atricat/wh51-emulation-sx1276/README.md

# wh51-emulation-sx1276

**Monitor your letterbox (or other device away from the house) with Home Assistant.**

This is code to emulate a WH51 soil moisture sensor with an ATtiny1614 MCU and a SX1276 (RFM95W) module. It transmits data that "fakes" the signals coming from an Ecowitt (Fine Offset) moisture sensor.

**Why would you need this?**

I needed a **long-range**, low-power (i.e. non 2.4GHz Wifi/Zigbee) **battery-powered** way to transmit sensor data to Home Assistant.
And I happened to already have WH51 moisture sensors and a gateway set up. These sensors use FSK modulation, and the SX1276 in the gateway can only listen either in FSK mode _or_ simple OOK/ASK mode. So it seemed easier to just "quickly" set something up to transmit using FSK. How naive... but I eventually got it to work.

**Alternative: ESPHome**: The [ESPHome SX127x component](https://esphome.io/components/sx127x/) potentially allows a similar setup: In a setup with multiple such SX127x ESPHome nodes, one of them acts as a gateway to Wi-Fi for Home Assistant, forwarding sensor data from the othres. Less coding, longer range if using LoRa, _but_ worse battery performance due to the use of ESP32, and you need another dedicated gateway running, instead of the one for the moisture sensors. Only little documentation exists, e.g. see [ESP32 LoRa Remote Sensor Node](https://esp32.co.uk/esp32-lora-remote-sensor-node-for-home-assistant-sx1276/).

**What works**

- Transmission at 868.35 MHz. The deviation of 35 kHz was measured with an SDR. Re-transmits after 5/10/60/300 seconds before going silent again, to ensure a new state goes through in case of e.g. radio interference.
- This shows up on my [LilyGo Lora32](https://lilygo.cc/products/lora3) (essentially an ESP32 and SX1276) running [OpenMQTTGateway](https://docs.openmqttgateway.com/), and thus also on Home Assistant.
- Logging to the same serial port that was used for programming the ATtiny. To enable logging, you need to press a key (e.g. Enter) during the first 3 seconds of startup, while the LED is still on.
- Reception of actual (genuine Ecowitt) WH51 transmissions, including AFC to figure out the exact frequency. (Needs a tiny bit of code hacking: Call the alternative `LoopRx()` from the start of `loop()`.)
- Home Assistant integration (see further below): If the mailbox flap/door is opened, send a notification to my phone. However, only do this if it is not me checking the mailbox - detect this by waiting for 5 minutes before the notification, and suppress it if the front door opens during that time.

**Caveats**

- For battery operation, note that the ATtiny will work from 1.8V at 5 MHz clock speed, from 2.7V at 10 MHz. So for best battery life, choose 5 MHz when compiling!
- 433 MHz and 915 MHz (SX1278 board) should work, but not tested.
- Unknown whether reception via the official Ecowitt gateway works, I do not own it.
- A [bug](https://github.com/1technophile/OpenMQTTGateway/issues/2356) in OpenMQTTGateway v1.8.1 prevented sending frequent updates, everything coming in from **any** device within 3 sec after an initial update was swallowed, even if the payload differed. It is **strongly recommended** to get a more recent version of OMG to avoid this problem. In the code, `MIN_UPDATE_DELAY_MS` (set to 3500 ms) provides a workaround, it causes updates of our device to get delayed until they will no longer be ignored. However, collisions with other devices within the 3 seconds cannot be avoided.

---

## Hardware notes

- MCU: ATtiny1614 (megaTinyCore / Arduino framework)
- Radio: SX1276, SPI, 32.000 MHz crystal (confirm yours matches - the frequency math in the code assumes exactly 32 MHz).
- PA output: configured for **PA_BOOST** (not RFO) - see "SX1276 TX register configuration" below. Most cheap SX1276 breakout boards (RFM95-style especially) only wire the antenna to PA_BOOST; RFO is often not connected at all on the PCB. If you are unsure about your board, first try reception only.
- **Never transmit without an antenna (or dummy load) connected.** An open-circuit PA output
  can degrade or damage the chip over repeated/high-power transmissions.

### Pin numbering

This is specific to the ATtiny1614 - take care to adapt as necessary for other MCUs.
[ATtiny1614/1616/1617 data sheet](https://ww1.microchip.com/downloads/aemDocuments/documents/MCU08/ProductDocuments/DataSheets/ATtiny1614-16-17-DataSheet-DS40002204A.pdf),
[SX1276 data sheet](https://www.semtech.com/products/wireless-rf/lora-connect/sx1276).

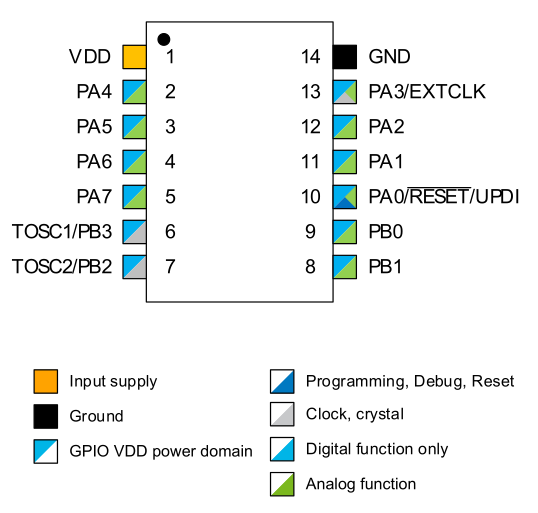
[picture p1: attiny1614-pinout.png]
pinout


| Physical pin | Name | Purpose |
|---|---|---|
| 1 | VDD  | 1.8V (at 5 MHz) to 3.3V - not 5V, the SX1276 does not like that |
| 2 | PA4  | SX1276 NSS/CS |
| 3 | PA5  | Reed 1 connected to GND |
| 4 | PA6  | Reed 2 connected to GND |
| 5 | PA7  | unused |
| 6 | PB3  | unused |
| 7 | PB2  | Serial output for log messages, see below |
| 8 | PB1  | Status LED connected to GND via ~330 Ohm (assuming a red LED) |
| 9 | PB0  | unused |
| 10 | PA0  | UPDI flashing |
| 11 | PA1  | SX1276 MOSI |
| 12 | PA2  | SX1276 MISO |
| 13 | PA3  | SX1276 SCK |
| 14 | GND  | Heh somehow it's needed |

The unused pins could of course be used for more analog or digital inputs.

_Implementation notes:_
I always use the named constants (`PIN_PA1`, `PIN_PB2`, etc.) rather than bare numbers to avoid confusion. This project got bitten by this repeatedly before switching to named constants everywhere.

Related, more general issue that applies beyond just this MCU: Raw AVR/megaAVR-0 registers expect different *kinds* of values depending on which register you're touching, and mixing
them up compiles fine but silently does the wrong thing:
- `DIRSET`/`DIRCLR`/`OUT.../IN`/`INTFLAGS` want a **bitmask** (`PIN1_bm`, or `digitalPinToBitMask(pin)`)
- `PORTx.PINnCTRL` access wants a **bit position** (`digitalPinToBitPosition(pin)`)
- Arduino API calls (`pinMode`, `digitalRead`, `digitalWrite`) want the **Arduino pin number**

### Serial/UPDI setup

**Raspberry Pico**

I used a Raspberry Pico with the [Noltari pico-uart-bridge](https://github.com/Noltari/pico-uart-bridge). With a simple setup with two resistors (however took a while to figure out the correct values), one can use the same cable to first program the ATtiny at 230400 baud, then read the output coming back at 9600 baud, e.g. using `minicom -D /dev/ttyACM0 -b 9600` (software/hardware flow control off!).

- Raspi Pico's GPIO16 (pin 21), UART0 TX is connected to a 1 kOhm resistor.
- Raspi Pico's GPIO17 (pin 22), UART0 RX is connected to the ATtiny UPDI (pin 10).
- Raspi Pico's GPIO17 (pin 22), UART0 RX is additionally connected to the other end of the 1 kOhm resistor.
- Another 470 Ohm resistor connects ATtiny UPDI (pin 10) with ATtiny PB2 (pin 7).

**CP2102 serial adapter**

A maybe nicer alternative to the above is to use [Philip McGaw's diode based approach](https://philipmcgaw.com/build-a-updi-programmer-from-a-usb-to-uart-adaptor/), it is an electrically "cleaner" design which possibly also allows higher baud rates for programming the ATtiny.

As above, to enable the logging feature, use a 470 Ohm resistor to connect ATtiny UPDI (pin 10) with ATtiny PB2 (pin 7).

_Implementation note:_
If (like this project) you multiplex a debug-UART TX pin so it can also serve as the UPDI programming line while the MCU sleeps, do not disable/re-enable `USART_TXEN_bm` around the sleep cycle. Doing so hits a quirk on these parts where the transmit data-register-empty flag gets stuck after TXEN is toggled off and back on, silently swallowing the first print after wake. The pin can be fully isolated for UPDI sharing using only `PORTx.DIR` (input before sleep, output after) - the USART peripheral overrides a pin's output *value* but not its *direction*, so `DIR=input` alone is sufficient isolation, and leaving TXEN permanently enabled the whole time sidesteps the quirk entirely.

## Assembled device

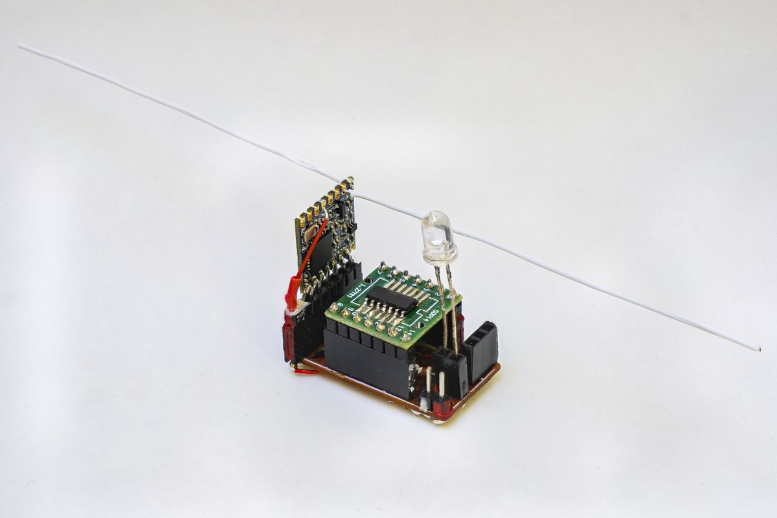
[picture p2: device-sm.jpeg]
assembled device


**Above:** Final setup with a simple dipole. This is just 2 pieces of solid copper wire soldered to ANT and GND. For 868 MHz, the length of each arm is 82 mm beyond the PCB, so about 83 mm including the PCB ([Half-Wave Dipole Antenna Calculator](https://rftools.io/calculators/antenna/dipole-antenna/?frequency=868.3&velocityFactor=0.95)). A surprisingly good antenna given the trivial design - better than the default coil antenna typically used with SX1276.

## Home Assistant integration

I built two of these devices - one in the letterbox (the reed sensors monitor the flap for letters resp. the door for packages) and one on the front door (reed sensors monitor open/close state resp. unlocked/locked state).

The first two sensor templates below translate fake moisture values to open/close etc states. The third template is used in the UI to display the sticky state (maintained in an `input_text`) that something was put in the mailbox. In `configuration.yaml`:

```
template:
  - sensor:
      - name: "haustuer_tpl"
        unique_id: haustuer_tpl
        state: >
          {% set moisture = states('sensor.fineoffset_wh51_513c0b_moisture') %}
          {{ {
            '0': 'open',
            '2': 'closed',
            '3': 'locked'
          }.get(moisture, 'unknown') }}
        icon: >
          {% set moisture = states('sensor.fineoffset_wh51_513c0b_moisture') %}
          {{ {
            '0': 'mdi:door-open',
            '2': 'mdi:door-closed',
            '3': 'mdi:door-closed-lock'
          }.get(moisture, 'mdi:door')
          }}
  - sensor:
      - name: "briefkasten_tpl"
        unique_id: briefkasten_tpl
        state: >
          {% set moisture = states('sensor.fineoffset_wh51_513c2f_moisture') %}
          {{ {
            '0': 'Paket+Brief',
            '1': 'Paket',
            '2': 'Brief',
            '3': 'closed'
          }.get(moisture, 'unknown') }}
        icon: >
          {% set moisture = states('sensor.fineoffset_wh51_513c2f_moisture') %}
          {{ {
            '0': 'mdi:mailbox-open',
            '1': 'mdi:mailbox-open',
            '2': 'mdi:mailbox-open',
            '3': 'mdi:mailbox'
          }.get(moisture, 'mdi:mailbox')
          }}
  - sensor:
      - name: briefkasten_ui
        state: "{{ states('input_text.briefkasten') }}"
        icon: >
          {% if states('input_text.briefkasten') != 'leer' %}
            mdi:mailbox-up
          {% else %}
            mdi:mailbox
          {% endif %}
```

The handling of the different steps happens in one multi-choice automation: Start the `timer.briefkasten` with a 5-minute timeout if the letterbox changes, cancel it if the front door changes while it is still running, send a notification if the timer triggers. `input_text.briefkasten` doubles as a global state variable and as the "letter" vs "package" detail to put into the notification text.

```
alias: Msg Briefkasten
description: ''
triggers:
  - trigger: state
    entity_id: sensor.briefkasten_tpl
    id: briefkasten
  - trigger: state
    entity_id: sensor.haustuer_tpl
    id: haustuer
  - trigger: timer.finished
    target:
      entity_id: timer.briefkasten
    options:
      behavior: each
      for: '00:00:00'
    id: timer
conditions: []
actions:
  - choose:
      - conditions:
          - condition: trigger
            id:
              - briefkasten
          - condition: state
            entity_id: sensor.briefkasten_tpl
            state:
              - Paket
              - Brief
              - Paket+Brief
        sequence:
          - action: timer.start
            metadata: {}
            target:
              entity_id: timer.briefkasten
            data:
              duration:
                hours: 0
                minutes: 5
                seconds: 0
          - action: input_text.set_value
            metadata: {}
            target:
              entity_id: input_text.briefkasten
            data:
              value: |
                {% set known = ['Paket', 'Brief'] %}
                {% set seen = (states('input_text.briefkasten').split('+')
                             + states('sensor.briefkasten_tpl').split('+')) %}
                {{ known | select('in', seen) | join('+') }}
        alias: 'briefkasten: start timer'
      - conditions:
          - condition: trigger
            id:
              - haustuer
        sequence:
          - action: timer.cancel
            metadata: {}
            target:
              entity_id: timer.briefkasten
            data: {}
          - action: input_text.set_value
            metadata: {}
            target:
              entity_id: input_text.briefkasten
            data:
              value: leer
        alias: 'haustuer: cancel timer'
      - conditions:
          - condition: trigger
            id:
              - timer
        sequence:
          - action: notify.notify
            metadata: {}
            data:
              message: 'Briefkasten: {{ states(''input_text.briefkasten'') }}'
mode: single
```

## SX1276 TX register configuration

```
RegOpMode      (0x01)  Standby = 0x01, TX = 0x03
                        NOTE: bit3 (LowFrequencyModeOn) must be 0 for 868/915 MHz operation.
                        Sequence: Standby -> load FIFO via SPI -> TX. (Triggering TX before
                        the FIFO is loaded, or leaving LowFrequencyModeOn set, are both easy
                        mistakes that silently produce no usable output.)

RegBitrateMsb/Lsb (0x02/0x03)   0x07, 0x40  ->  32MHz / 1856 ~= 17.241 kbit/s

RegFdevMsb/Lsb    (0x04/0x05)   ~30 kHz assumed (0x01, 0xEB) - NOT independently confirmed
                                 against the real sensor's true deviation. See "Open questions"
                                 below - this is the most likely remaining unknown.

RegFrfMsb/Mid/Lsb (0x06/0x07/0x08)  See frequency discussion below - true carrier measured
                                     at ~868.350 MHz, not the commonly-quoted 868.300 MHz.
                                     Frf = round(Freq_Hz * 2^19 / 32,000,000)

RegPaConfig    (0x09)  0x8F  (bit7=1 selects PA_BOOST; OutputPower=15 -> ~17 dBm)

RegFifoThresh  (0x35)  0x8F  (TxStartCondition = FifoNotEmpty)
                        CRITICAL for short payloads: the power-on default requires the FIFO
                        to exceed a 15-byte threshold before TX will even start. The WH51
                        payload is only 14 bytes, so with the default setting TX silently
                        never starts at all (PacketSent never fires) - it's not a timeout,
                        the chip just sits waiting for a FIFO level it will never reach.

RegPreambleMsb/Lsb (0x25/0x26)  0x00, 0x08  (8 bytes of preamble; started at 4, increased for
                                             margin - real receivers often want more preamble
                                             than the theoretical minimum to reliably settle
                                             bit-sync from a cold RX state)

RegSyncConfig  (0x27)  0x11  (SyncOn=1, 2-byte sync word)
RegSyncValue1  (0x28)  0x2D
RegSyncValue2  (0x29)  0xD4

RegPacketConfig1 (0x30)  0x00  (fixed-length packets, no radio-level CRC - CRC is computed
                                 and appended manually as part of the WH51 payload format)
RegPayloadLength (0x32)  14    (NOT 0x38 in terms of register address - see below)
```

### Modulation shaping / PA ramp (`RegPaRamp`, 0x0A)

Left at power-on default: `ModulationShaping` = `00` (none/hard-keyed FSK), bits[3:0] = default
ramp time. Real Fine Offset sensor hardware is presumed (not confirmed) to use simple unshaped
FSK, consistent with this being cost-optimized sensor hardware rather than something using
Gaussian filtering (GFSK). Bit layout for reference: bits[6:5]=ModulationShaping
(00=None/01=GaussianBT1.0/10=GaussianBT0.5/11=GaussianBT0.3), bits[3:0]=ramp time.

---

## The WH51 packet format (reverse-engineered / confirmed against real hardware)

Source of truth: `rtl_433`'s own `fineoffset.c` decoder (the same decoder OMG's `rtl_433_ESP`
library ports), cross-checked and independently verified by capturing real
packets from two genuine WH51 units and recomputing both integrity fields in code - all matched.

14 bytes total, following preamble (`0xAA` repeated) + 2-byte sync (`0x2D 0xD4`):

| Byte(s) | Field |
|---|---|
| 0 | Family code, must be `0x51` |
| 1-3 | Sensor ID (3 bytes, arbitrary/self-assigned) |
| 4 | bits[7:5] = "boost" counter (7 immediately after a change event, decrementing each subsequent TX, 0 at steady state - also affects TX interval: ~10s while boosted, ~70s at steady state); bits[4:0] = battery decivolts (e.g. `0x0F` = 15 = 1500 mV) |
| 5 | Fixed `0x7F` |
| 6 | Moisture %, `0x00`-`0x64` (0-100) |
| 7 | bits[7:1] fixed pattern `1111100`; bit[0] = MSB of 9-bit "AD raw" value |
| 8 | LSB of AD raw value |
| 9-11 | Fixed `0xFF 0xFF 0xFF` |
| 12 | CRC-8 (poly `0x31`, init `0x00`, **non-reflected**/MSB-first) over bytes 0-11 |
| 13 | Additive checksum: `sum(bytes 0-12) mod 256` |

Real-world example (sensor `0f5694`):
```
51 0f 56 94 0f 7f 00 f8 38 ff ff ff 6e 73
```
`0x51`=family,\
`0f 56 94`=ID,\
`0x0f`=boost=0/battery=1500mV,\
`0x7f`=fixed,\
`0x00`=moisture 0%,\
`0xf8`=AD-MSB-bit=0 with fixed pattern,\
`0x38`=AD-LSB (AD raw=56),\
`ff ff ff`=fixed,\
`0x6e`=CRC8(bytes 0-11),\
`0x73`=checksum(bytes 0-12).

Note that the decoder does not validate `moisture` or `ad_raw` against each other or against any expected range - those two fields can be set to whatever you want to represent, such as reed sensors in this case.

---

## Frequency question: 868.300 vs 868.350 MHz

Commonly-quoted configs for EU Fine Offset devices and `rtl_433_ESP`'s own documented build-flag example) use **868.300 MHz**. Using an SX1276 configured for genuine FSK packet-mode reception (not the OOK trick described below) with AFC enabled, and reading back the measured frequency-offset register after real, successful packet captures from two different genuine WH51 units, the true transmit carrier consistently measured ~868.350 MHz.

`Frf` calculation reference:
```
FSTEP = 32,000,000 Hz / 2^19 = 61.03515625 Hz
Frf   = round(Freq_Hz / FSTEP)
```

---

## Retargeting to other ISM bands (433 MHz / 915 MHz)

Likely values to use for these:

| Target frequency | `Frf` (decimal) | MSB | MID | LSB |
|---|---|---|---|---|
| 433.920 MHz | 7,109,345 | `0x6C` | `0x7A` | `0xE1` |
| 915.000 MHz | 14,991,360 | `0xE4` | `0xC0` | `0x00` |

868.350 MHz, this project's own working frequency, is covered above.

Note that register changes alone are not sufficient - most SX127x breakout boards have their antenna matching network (and also the antenna itself) physically tuned for one specific band at manufacture time. A board built for 868/915 MHz will radiate poorly, if at all, if you simply reprogram it for 433 MHz - you need a module actually designed for the target band. The registers will happily accept any value and `PacketSent` will still fire normally regardless of whether the antenna is actually resonant at that frequency.

---

## OMG's receive architecture

_This section courtesy of Claude who also helped figure out much of the above. But ChatGPT produced a similar theory._

This could be useful for anyone attempting a similar
project against OMG/`rtl_433_ESP` specifically, because it's easy to wrongly assume OMG does
conventional FSK packet-mode reception (matching deviation/bitrate/sync-word registers the way
this project's own RX diagnostic code does) when **it does not**.

Direct review of `rtl_433_ESP`'s source (`rtl_433_ESP.cpp`) shows that for SX1276/SX1278, OMG
configures the radio in **OOK (On-Off Keying) mode**, not FSK packet mode:
```
radio.setDataShapingOOK(2);
radio.setOokThresholdType(RADIOLIB_SX127X_OOK_THRESH_PEAK);
radio.setOokFixedOrFloorThreshold(OokFixedThreshold);  // default 0x0C
```
It uses RadioLib's "direct mode" - the chip outputs a raw demodulated bitstream on a GPIO pin,
which the ESP32 captures via interrupt-timestamped edges, and decodes entirely in **software**
using `rtl_433`'s generic pulse-timing decoders. Architecturally this is the same approach
`rtl_433` uses against a raw SDR dongle - the SX1276 is being used as a crude analog
envelope/threshold detector, not as a packet-engine radio.

This matters because receiving a genuinely FSK-modulated signal via OOK/peak detection is a
known, deliberate trick: tune the receiver's *narrow* filter to sit over only **one** of the two
FSK tones (mark or space, i.e. `carrier ± deviation`), so a frequency shift becomes an amplitude
on/off shift a simple threshold slicer can read as bits. Under this model, OMG's commonly-used
"868.300 MHz" isn't the true carrier at all - it's a deliberately offset tuning point positioned
to catch only one tone, and the ~50 kHz gap to the true measured carrier (868.350 MHz) was
hypothesized to approximate the real transmitter's deviation.

---

## Diagnostic techniques that proved valuable

How do you figure out which parts of the setup work already, and where we are stuck?

- **SPI: `RegVersion` (0x42) readback, expect `0x12`** - the standard first sanity check that SPI
  wiring/power/chip presence are all fine, before debugging anything else.
- **SPI round-trip test**: write a test byte to an unused scratch register (e.g.
  `RegSyncValue3`, `0x2A`, if you only use a 2-byte sync word) and read it back, to confirm
  writes (not just reads) are reaching the chip.
- **SX1276 `PacketSent` polling (`RegIrqFlags2` bit 3) instead of a blind fixed TX delay** - confirms
  the digital packet engine actually completed, and with a timeout, distinguishes "TX genuinely
  stalled" (e.g. the `RegFifoThresh` bug above) from "TX completed but nothing useful was
  radiated." **Important limitation to remember**: `PacketSent` only proves the *digital*
  side finished - it says nothing about whether real RF power actually left the antenna (that's
  downstream, in the analog PA stage, and can fail silently - e.g. wrong PA_BOOST/RFO pin
  selection - while `PacketSent` still fires normally).
- **A temporary RX-mode build of the same firmware, listening for real reference hardware**,
  was extremely valuable for isolating "is my antenna/RF chain even fundamentally OK" from
  "is my packet content/protocol correct" - two failure categories that look identical from the
  TX side alone (silence either way) but are very different problems. Concretely: put the
  SX1276 in continuous Receiver mode (`RegOpMode=0x05`), poll `RegIrqFlags1` bit0
  (`SyncAddressMatch`) and `RegIrqFlags2` bit2 (`PayloadReady`), dump FIFO bytes + RSSI on each
  hit. **Filter dumps by the expected family byte** (`0x51` here) - raw sync-word matching on
  its own catches a meaningful amount of pure background-noise false positives (statistically
  expected at roughly `listen_time_sec × bitrate / 2^16` for a 16-bit sync word), which can look
  confusingly like "reception" if you don't cross-check packet content.
- **AFC (`RegRxConfig` AfcAutoOn, `RegAfcBw` wider than `RegRxBw`, then read back
  `RegAfcMsb/Lsb`, each LSB ~ FSTEP ~ 61.035 Hz)** is a good way to measure a real transmitter's
  *actual* carrier frequency precisely, once you can receive it at all, rather than trusting a
  commonly-quoted "nominal" frequency that may (as here) turn out to not be the true carrier.
