atricat/wh51-emulation-sx1276/(commit log)

2026-08-11 40khz dev, 36ms gap, lower tx power
2026-08-23 MIN_UPDATE_DELAY_MS to work around OMG bug for too frequent updates
    [config.h, wh51-emulation-sx1276.ino]
2026-09-13 Wait >150ms before retransmit, else OpenMQTTGateway won't catch it
    [config.h]
2026-09-13 bugfix: Flip correct bit for 433 MHz
    [sx1276.cpp]
2026-09-14 retry in case of tx error
    [wh51-emulation-sx1276.ino]
2026-09-14 increase MIN_UPDATE_DELAY_MS for better safety margin against bug #2356
    [config.h]
2026-09-16 Fix various races which could swallow reed changes.
    [wh51-emulation-sx1276.ino]
2026-09-17 Add several retransmissions, deep sleep with timer interrupts
